JoKlasen/tsea29-autonom-taxibil/README.md

# Projekt - Taxibil
## TSEA29 - HT22 - G13

Det här är ett importerat kodrepo från liu.gitlab för arkivering av projektarbetet som vi utförde för att konstruera en autonom taxibil.
En del branches och commits kan saknas då det här var det enda jag hade sparat lokalt innan originalrepot på gitlab togs bort.

Medverkande i gruppen var Linus Thorsell, Oscar Sandell, Hannes Nöranger, Zackarias Wadströmer, Thomas Pilotti Wiger och mig, Johan Klasén.

För en bättre beskrivning av projektet se den [Tekniska dokumentationen](https://github.com/JoKlasen/tsea29-autonom-taxibil/blob/master/docs/tekdok/tekdok_1.0_grupp13.pdf), eller övriga projektdokument.
