JoKlasen/tsea29-autonom-taxibil/control-module/README.md

# Control Module
## Controls Motor and Servos via PWM signals.

Servo controller 1-2ms @ 50Hz
Motor controller 1.5ms +- ? @ 2000Hz
