JoKlasen/tsea29-autonom-taxibil/app-module/README.md

# WebApp(-module)
## Handles PID value initialization, Manual Control, Debugging and Tracking of the Taxi
