JoKlasen/tsea29-autonom-taxibil/communication-module/README.md

# Communication Module
## Handles communication between taxi-modules and the app-module.
### Is also responsible for the image-recognition from the camera.

This is the largest module, running on a raspberry pi.
