JoKlasen/tsea29-autonom-taxibil/sensor-module/README.md

# Sensor Module
## Responsible for fetching sensor data from the sensors and sending the data to the communcations module.
