JoKlasen/tsea29-autonom-taxibil/docs/generell_sv.pdf

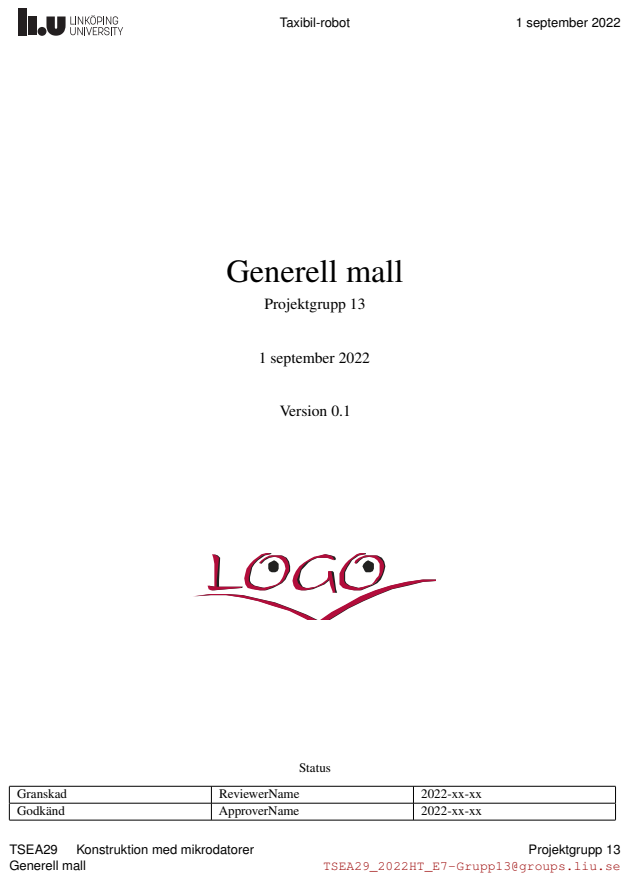
[picture p33: page 1]
Taxibil-robot; 1 september 2022; Generell mall; Projektgrupp 13; Version 0.1; Status; TSEA29; Konstruktion med mikrodatorer

Granskad | ReviewerName | 2022-xx-xx
Godkänd | ApproverName | 2022-xx-xx

TSEA29_2022HT_E7-Grupp13@groups.liu.se

Taxibil-robot | 1 september 2022

Projektidentitet

Grupp E-post: | TSEA29_2022HT_E7-Grupp13@groups.liu.se
Hemsida: | https://gitlab.liu.se/da-proj/microcomputer-project-laboratory-d/2022/g13
Beställare: | Anders Nilsson, ISY, Linköpings universitet Tfn: 013-28 26 35 E-post: anders.p.nilsson@liu.se
Kund: | Anders Nilsson, ISY, Linköpings universitet Tfn: 013-28 26 35 E-post: anders.p.nilsson@liu.se
Handledare: | Peter Johansson Tfn: 013-28 1345 E-post: peter.a.johansson@liu.se
Kursansvarig: | Anders Nilsson, ISY, Linköpings universitetn Tfn: 013-28 26 35 E-post: anders.p.nilsson@liu.se

## Projektdeltagare

Namn | Ansvar | Telefon | E-post
Linus Thorsell | Projektledare | 0765612171 | linth181@student.liu.se
Oscar Sandell | Testansvarig | 0709416866 | oscsa604@student.liu.se
Hannes Nöranger | Utvecklare | 0733118779 | hanno696@student.liu.se
Johan Klasén | Dokumentansvarig | 0730982555 | johkl473@student.liu.se
Zackarias Wadströmer | Utvecklare | 0706142029 | zacwa923@student.liu.se
Thomas Pilotti Wiger | Konstruktionsansvarig | 0761708593 | thopi836@student.liu.se
TSEA29 | Konstruktion med mikrodatorer
Generell mall

Projektgrupp 13

TSEA29_2022HT_E7-Grupp13@groups.liu.se

Taxibil-robot | 1 september 2022

### C O N T E N T S

1 Första kapitlet | 1
2 Andra kapitlet | 2
3 Tredje kapitlet | 2
4 LATEX | 4
A | Första appendix | 7
B | Andra appendix | 7
TSEA29 | Konstruktion med mikrodatorer
Generell mall

Projektgrupp 13

TSEA29_2022HT_E7-Grupp13@groups.liu.se

Taxibil-robot | 1 september 2022

### D O K U M E N T H I S TO R I K

Version | Datum | Utförda förändringar | Utförda av | Granskad
0.1 | 2015-11-01 | Första utkast | Sign1 | Name1
0.2 | 2015-11-03 | Första revision | Sign2 | Name2
TSEA29 | Konstruktion med mikrodatorer
Generell mall

Projektgrupp 13

TSEA29_2022HT_E7-Grupp13@groups.liu.se

Taxibil-robot | 1 september 2022

### 1 F Ö R S TA K A P I T L E T

Detta är en text. Detta är kursiv text. Detta är text i fetstil.

### 1.1 Alternativ till dokumentmall

Följande alternativ kan specificeras till dokumentmallen:

- Språk: english (default) eller swedish
- Sidlayout: oneside (default) eller twoside
- Fontstorlek: 10pt (default), 11pt, eller 12pt

Exempel på mallaktivering

\documentclass[10pt,oneside,english]{lips}

### 1.2 Rubrik nivå 2

Sed commodo posuere pede. Mauris ut est. Ut quis purus. Sed ac odio. Sed vehicula hendrerit sem. Duis non odio. Morbi ut dui. Sed accumsan risus eget odio. In hac habitasse platea dictumst. Pellentesque non elit. Fusce sed justo eu urna porta tincidunt. Mauris felis odio, sollicitudin sed, volutpat a, ornare ac, erat. Morbi quis dolor. Donec pellentesque, erat ac sagittis semper, nunc dui lobortis purus, quis congue purus metus ultricies tellus. Proin et quam. Class aptent taciti sociosqu ad litora torquent per conubia nostra, per inceptos hymenaeos. Praesent sapien turpis, fermentum vel, eleifend faucibus, vehicula eu, lacus.

### 1.2.1 Rubrik nivå 3

Sed commodo posuere pede. Mauris ut est. Ut quis purus. Sed ac odio. Sed vehicula hendrerit sem. Duis non odio. Morbi ut dui. Sed accumsan risus eget odio. In hac habitasse platea dictumst. Pellentesque non elit. Fusce sed justo eu urna porta tincidunt. Mauris felis odio, sollicitudin sed, volutpat a, ornare ac, erat. Morbi quis dolor. Donec pellentesque, erat ac sagittis semper, nunc dui lobortis purus, quis congue purus metus ultricies tellus. Proin et quam. Class aptent taciti sociosqu ad litora torquent per conubia nostra, per inceptos hymenaeos. Praesent sapien turpis, fermentum vel, eleifend faucibus, vehicula eu, lacus.

### 1.3 Andra rubrik nivå 2

Sed commodo posuere pede. Mauris ut est. Ut quis purus. Sed ac odio. Sed vehicula hendrerit sem. Duis non odio. Morbi ut dui. Sed accumsan risus eget odio. In hac habitasse platea dictumst. Pellentesque non elit. Fusce sed justo eu urna porta tincidunt. Mauris felis odio, sollicitudin sed, volutpat a, ornare ac, erat. Morbi quis dolor. Donec pellentesque, erat ac sagittis semper, nunc dui lobortis purus, quis congue purus metus ultricies tellus. Proin et quam. Class aptent taciti sociosqu ad litora torquent per conubia nostra, per inceptos hymenaeos. Praesent sapien turpis, fermentum vel, eleifend faucibus, vehicula eu, lacus.

TSEA29 | Konstruktion med mikrodatorer
Generell mall | 1

Projektgrupp 13

TSEA29_2022HT_E7-Grupp13@groups.liu.se

Taxibil-robot | 1 september 2022

### 1.4 Tredje rubrik nivå 2

Mer text och en Laplace-transform av funktionen f(t) F(s) = Z ∞

−∞

f(t)e

−st dt. | (1)

### 2 A N D R A K A P I T L E T

Eulers identitet med π är
e
iπ + 1 = 0 | (2)

och med τ, se [1] (se detta som ett exempel på hur on-line resurser kan citeras),

e

iτ = 1 | (3)

så här citeras ett vetenskapligt arbete[2], och så här skrivs en fotnot¹
. Information om de citerade arbetena skrivs i
filen references.bib.

### 2.1 Ytterligare en rubrik på nivå 2

Suspendisse vitae elit. Aliquam arcu neque, ornare in, ullamcorper quis, commodo eu, libero. Fusce sagittis erat at erat tristique mollis. Maecenas sapien libero, molestie et, lobortis in, sodales eget, dui. Morbi ultrices rutrum lorem. Nam elementum ullamcorper leo. Morbi dui. Aliquam sagittis. Nunc placerat. Pellentesque tristique sodales est. Maecenas imperdiet lacinia velit. Cras non urna. Morbi eros pede, suscipit ac, varius vel, egestas non, eros. Praesent malesuada, diam id pretium elementum, eros sem dictum tortor, vel consectetuer odio sem sed wisi.
Z b

a

f

0
(x) dx = f(b) − f(a) | (4)

### 3 T R E D J E K A P I T L E T

Matlab-kod kan infogas prydligt via paketet listings.sty, exempelvis så här² .

1 | function r = rank(A,tol)
% RANK | Matrix rank.
3 | % | RANK(A) provides an estimate of the number of linearly
| % | independent rows or columns of a matrix A.
5 | % | RANK(A,tol) is the number of singular values of A
| % | that are larger than tol.
7 | % | RANK(A) uses the default tol = max(size(A)) * eps(norm(A)).
| %
9 | % | Class support for input A:

1 Var konsistent med hur ni citerar, i kandidatprojekt i elektronik så används fotnötter mycket sparsamt. 2 Här, koden från Matlab-kommandot rank används som exempel.

TSEA29 | Konstruktion med mikrodatorer
Generell mall | 2

Projektgrupp 13

| | TSEA29_2022HT_E7-Grupp13@groups.liu.se

Taxibil-robot | 1 september 2022
% | float: double, single
11
% Copyright 1984-2007 The MathWorks, Inc.
13
s = svd(A);
15 if nargin==1

tol = max(size(A)) * eps(max(s)); 17 end
r = sum(s > tol);

eller Pythonkod enligt:

d e f fi n d _ma x ( L ) :
i f l e n ( L ) == 1 :
r e t u r n L [ 0 ]
v1 = L [ 0 ]
v2 = fi n d _ma x ( L [ 1 : ] ) i f v1 > v2 :
r e t u r n v1
e l s e :
r e t u r n v2

### 3.1 Inkludera figurer

Sed commodo posuere pede. Mauris ut est. Ut quis purus. Sed ac odio. Sed vehicula hendrerit sem. Duis non odio. Morbi ut dui. Sed accumsan risus eget odio. In hac habitasse platea dictumst. Pellentesque non elit. Fusce sed justo eu urna porta tincidunt. Mauris felis odio, sollicitudin sed, volutpat a, ornare ac, erat. Morbi quis dolor. Donec pellentesque, erat ac sagittis semper, nunc dui lobortis purus, quis congue purus metus ultricies tellus. Proin et quam. Class aptent taciti sociosqu ad litora torquent per conubia nostra, per inceptos hymenaeos. Praesent sapien turpis, fermentum vel, eleifend faucibus, vehicula eu, lacus.
Figur 1 vidsar en berömd bild på jorden från Apollo 17.


Figure 1: Det berömda ’The blue marble’ fotot.

TSEA29 | Konstruktion med mikrodatorer
Generell mall | 3

Projektgrupp 13

TSEA29_2022HT_E7-Grupp13@groups.liu.se

Taxibil-robot | 1 september 2022

## 4 LATEX

Den här texten är ingen introduktion till LATEX. För mer information, se online-resurser exempelvis på [3], där en bra start är dokumentet http://ctan.org/pkg/lshort. Därifrån kan även mjukvara for Linux http://www.
tug.org/texlive/, för Mac http://www.tug.org/mactex/, och för Windows http://www.miktex.
org (http://www.miktex.org) laddas ned.
För att typsätta det här dokumentet skriv

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

vid en terminal prompt för att producera filen generell_sv.pdf.

### 4.1 Att skriva krav

Sed commodo posuere pede. Mauris ut est. Ut quis purus. Sed ac odio. Sed vehicula hendrerit sem. Duis non odio. Morbi ut dui. Sed accumsan risus eget odio. In hac habitasse platea dictumst. Pellentesque non elit. Fusce sed justo eu urna porta tincidunt. Mauris felis odio, sollicitudin sed, volutpat a, ornare ac, erat. Morbi quis dolor. Donec pellentesque, erat ac sagittis semper, nunc dui lobortis purus, quis congue purus metus ultricies tellus. Proin et quam. Class aptent taciti sociosqu ad litora torquent per conubia nostra, per inceptos hymenaeos. Praesent sapien turpis, fermentum vel, eleifend faucibus, vehicula eu, lacus.
Det finns en miljö (environment) för att skriva krav, hantera numrering, och göra det möjligt att referera individuella krav. Det skall se bra ut även när tabellen spänner över flera sidor. Se källkoden för tabellen med krav nedan.
Krav | Version | Beskrivning | Prioritet
1 2 3 4 5 6 7 8 9 10 11 12 13 14 15 16 17 18 | Description Description Description Description Description Description Description Description Description Description Description Description Description Description Description Description Description Description | 2 1 1 1 1 1 1 1 1 2 1 1 1 1 1 1 1 1

forts. på nästa sida

TSEA29 | Konstruktion med mikrodatorer
Generell mall | 4

Projektgrupp 13

TSEA29_2022HT_E7-Grupp13@groups.liu.se

Taxibil-robot | 1 september 2022

forts. från föregående sida
Krav | Version | Beskrivning | Prioritet
19 20 21 22 23 24 25 26 27 28 29 30 | Description Description Description Description Description Description Description Description Description Description Description Description | 1 1 1 1 1 1 1 1 1 1 1 1

Notera att kraven 1 och 10 har prioritet 2.

TSEA29 | Konstruktion med mikrodatorer
Generell mall | 5

Projektgrupp 13

TSEA29_2022HT_E7-Grupp13@groups.liu.se

Taxibil-robot | 1 september 2022

### R E F E R E N C E S

[1] V. Hart, “PI is (still) wrong,” https://youtu.be/jG7vhMMXagQ, 2011, [Online; accessed October 30, 2015].
[2] A. Einstein, “Uber einen die erzeugung und verwandlung des lichtes betreffenden heurischen gesichtpunkt,” Ann. Phys., vol. 17, pp. 132–148, 1905.
[3] TUG, “TeX User Group web site,” http://www.tug.org, [Online; accessed October 30, 2015].
TSEA29 | Konstruktion med mikrodatorer
Generell mall | 6

Projektgrupp 13

TSEA29_2022HT_E7-Grupp13@groups.liu.se

Taxibil-robot | 1 september 2022
A | F Ö R S TA A P P E N D I X

A.1 Första underkapitel i första appendix

Fusce mauris. Vestibulum luctus nibh at lectus. Sed bibendum, nulla a faucibus semper, leo velit ultricies tellus, ac venenatis arcu wisi vel nisl. Vestibulum diam. Aliquam pellentesque, augue quis sagittis posuere, turpis lacus congue quam, in hendrerit risus eros eget felis. Maecenas eget erat in sapien mattis porttitor. Vestibulum porttitor. Nulla facilisi. Sed a turpis eu lacus commodo facilisis. Morbi fringilla, wisi in dignissim interdum, justo lectus sagittis dui, et vehicula libero dui cursus dui. Mauris tempor ligula sed lacus. Duis cursus enim ut augue. Cras ac magna. Cras nulla. Nulla egestas. Curabitur a leo. Quisque egestas wisi eget nunc. Nam feugiat lacus vel est. Curabitur consectetuer.

A.1.1 Under underkapitel i första appendix

En text.

A.2 Andra underkapitel i första appendix

Fusce mauris. Vestibulum luctus nibh at lectus. Sed bibendum, nulla a faucibus semper, leo velit ultricies tellus, ac venenatis arcu wisi vel nisl. Vestibulum diam. Aliquam pellentesque, augue quis sagittis posuere, turpis lacus congue quam, in hendrerit risus eros eget felis. Maecenas eget erat in sapien mattis porttitor. Vestibulum porttitor. Nulla facilisi. Sed a turpis eu lacus commodo facilisis. Morbi fringilla, wisi in dignissim interdum, justo lectus sagittis dui, et vehicula libero dui cursus dui. Mauris tempor ligula sed lacus. Duis cursus enim ut augue. Cras ac magna. Cras nulla. Nulla egestas. Curabitur a leo. Quisque egestas wisi eget nunc. Nam feugiat lacus vel est. Curabitur consectetuer.

A.2.1 Under underkapitel i första appendix

En text

### B A N D R A A P P E N D I X

B.1 Första underkapitel i andra appendix

Fusce mauris. Vestibulum luctus nibh at lectus. Sed bibendum, nulla a faucibus semper, leo velit ultricies tellus, ac venenatis arcu wisi vel nisl. Vestibulum diam. Aliquam pellentesque, augue quis sagittis posuere, turpis lacus congue quam, in hendrerit risus eros eget felis. Maecenas eget erat in sapien mattis porttitor. Vestibulum porttitor. Nulla facilisi. Sed a turpis eu lacus commodo facilisis. Morbi fringilla, wisi in dignissim interdum, justo lectus sagittis dui, et vehicula libero dui cursus dui. Mauris tempor ligula sed lacus. Duis cursus enim ut augue. Cras ac magna. Cras nulla. Nulla egestas. Curabitur a leo. Quisque egestas wisi eget nunc. Nam feugiat lacus vel est. Curabitur consectetuer.

TSEA29 | Konstruktion med mikrodatorer
Generell mall | 7

Projektgrupp 13

TSEA29_2022HT_E7-Grupp13@groups.liu.se

Taxibil-robot | 1 september 2022

B.1.1 Under underkapitel i andra appendix

En text

B.2 Andra underkapitel i andra appendix

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

B.2.1 Under underkapitel i andra appendix

En text

TSEA29 | Konstruktion med mikrodatorer
Generell mall | 8

Projektgrupp 13

TSEA29_2022HT_E7-Grupp13@groups.liu.se
