JoKlasen/tsea29-autonom-taxibil/docs/efterstudie/efterstudie_1.0_grupp13.pdf

Taxibil-robot | 20 december 2022

# Efterstudie

Projektgrupp 13

20 december 2022

Version 1.0

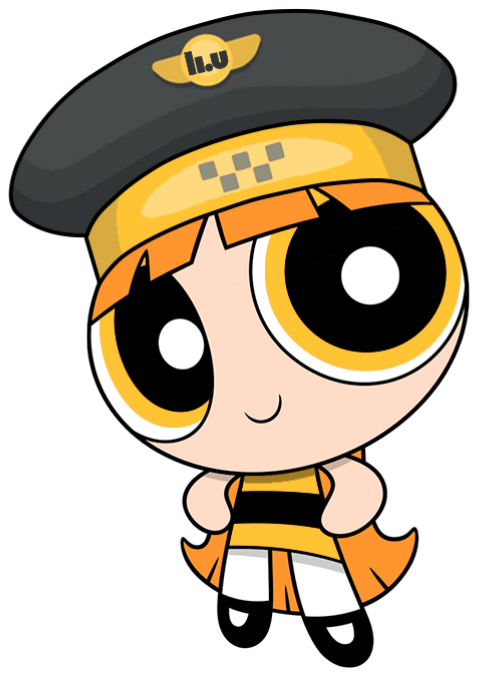
[picture p34: figure]

Status

Granskad | Johan Klasén | 2022-12-20
Godkänd | | 2022-12-20
TSEA29 | Konstruktion med mikrodatorer
Efterstudie

Projektgrupp 13

TSEA29_2022HT_E7-Grupp13@groups.liu.se

Taxibil-robot | 20 december 2022

Projektidentitet

Grupp E-post: | TSEA29_2022HT_E7-Grupp13@groups.liu.se
Hemsida: | https://gitlab.liu.se/da-proj/microcomputer-project-laboratory-d/2022/g13
Beställare: | Anders Nilsson, ISY, Linköpings universitet Tfn: 013-28 26 35 E-post: anders.p.nilsson@liu.se
Kund: | Anders Nilsson, ISY, Linköpings universitet Tfn: 013-28 26 35 E-post: anders.p.nilsson@liu.se
Handledare: | Peter Johansson Tfn: 013-28 1345 E-post: peter.a.johansson@liu.se
Kursansvarig: | Anders Nilsson, ISY, Linköpings universitetn Tfn: 013-28 26 35 E-post: anders.p.nilsson@liu.se

## Projektdeltagare

Namn | Ansvar | Telefon | E-post
Linus Thorsell | Projektledare | 0765612171 | linth181@student.liu.se
Oscar Sandell | Testansvarig | 0709416866 | oscsa604@student.liu.se
Hannes Nörager | Utvecklare | 0733118779 | hanno696@student.liu.se
Johan Klasén | Dokumentansvarig | 0730982555 | johkl473@student.liu.se
Zackarias Wadströmer | Utvecklare | 0706142029 | zacwa923@student.liu.se
Thomas Pilotti Wiger | Konstruktionsansvarig | 0761708593 | thopi836@student.liu.se
TSEA29 | Konstruktion med mikrodatorer
Efterstudie

Projektgrupp 13

TSEA29_2022HT_E7-Grupp13@groups.liu.se

Taxibil-robot | 20 december 2022

### I N N E H Å L L

1 Tidsåtgång | 1
2 Analys av arbete och problem | 1
3 Måluppfyllelse | 3
4 Sammanfattning | 3
TSEA29 | Konstruktion med mikrodatorer
Efterstudie

Projektgrupp 13

TSEA29_2022HT_E7-Grupp13@groups.liu.se

Taxibil-robot | 20 december 2022

### D O K U M E N T H I S TO R I K

Version | Datum | Utförda förändringar | Utförda av | Granskad
1.0 | 2022-12-20 | Första versionen | Gruppen | Johan
TSEA29 | Konstruktion med mikrodatorer
Efterstudie

Projektgrupp 13

TSEA29_2022HT_E7-Grupp13@groups.liu.se

Taxibil-robot | 20 december 2022

### 1 T I D S ÅT G Å N G

### 1.1 Arbetsfördelning

Vi har haft problem med att se till att det är en jämn arbetsfödelning genom hela projektet då det bara fanns en uppsättning hårdvara och majoriteten av arbetet riktades just mot denna del hårdvara. Det var för stor gruppstorlek för att endast ha en uppsättning bil. Vi har inte heller tagit höjd i planeringen för hur arbetet ska läggas upp efter att vissa nyckelsteg har uppnåtts, vilket fått personer att stå utan arbetsuppgift.

### 1.2 Tidsåtgång jämfört med planerad tid

Det var svårt att uppskatta projektets tidsåtgång men baserat på erfarenheter etc. tog vi fram en tidsplan. Denna visade sig stämma bra med hur mycket tid som behövde läggas ner för att nå projektets mål.

Fas | Planerad tid (h) | Använd tid (h)
Innan BP3 | 40 | 40
Under projektet | 855 | 863
Efter BP5 | 65 | 27,5

### 2 A N A LY S AV A R B E T E O C H P R O B L E M

Under arbetets gång har vi stött på flera problem. Allt från hårdvaruproblem, installation av bibliotek som inte fungerade som förväntat till en variation av tekniska problem/utmaningar rörande exekveringstid. Dessa har fått lösas på olika sätt, t.ex med hjälp från handledare med hårdvarubrister som gruppen inte kunde lösa själva. Bibliotek och annan variation på mjukvaruproblem löstes av gruppen till slut. Dessa tog mycket tid från projektet och gjorde problemen rörande exekveringstid svårare att felsöka, samt fördröjde efterföljande arbete. Slutligen så är det relevant att nämna att gruppen mötte en del kommunikationsproblem, mestadels via meddelanden, som gjorde det svårt för vissa medlemmar att engagera sig i relevant arbete.

### 2.1 Vad hände under de olika faserna (bra/dåligt/orsak)?

Förarbetet/designfasen flöt på bra. Det gav en bra möjlighet för alla att samla in kunskap och gruppen kunde komma överens en generell bild av hur systemet skulle se ut och vad som behövde göras. En del aktiviteter kunde eventuellt ha utökats, med det är alltid svårt att designa något helt från början utan att ha sett eller bekantat sig med hårdvaran man jobbat med eller att börja testa kodstycken. Vi gjorde vårt bästa för att försöka uppskatta aktiviteters tidsåtgång, men dessa skulle ha behövts reviderats en bit inpå projektets gång.

Under själva implementeringsfasen flöt arbetet på väldigt bra i början. Aktiviteterna stämde bra överens med vad som behövde göras och alla hade tydliga uppgifter. Längre in i projektet märkte vi att det fanns rätt mycket uppgifter som inte täcktes av någon aktivitet och andra aktiviteter inte väl speglade vad som faktiskt behövde göras. Arbetsfördelningen för aktiviteterna var inte helt optimal då vissa gruppmedlemmar snabbt klarade aktiviteterna de var tilldelade men inte hade en tydlig bild av vad för arbete dom skulle gå över till. Här skulle det ha behövts att vi någon gång gemensamt skulle gått igenom och reviderat planeringen.

TSEA29 | Konstruktion med mikrodatorer
Efterstudie | 1

Projektgrupp 13

TSEA29_2022HT_E7-Grupp13@groups.liu.se

Taxibil-robot | 20 december 2022

### 2.2 Hur vi arbetade tillsammans (ansvar, beslut, kommunikation etc.)?

Samarbetet har varit en svår del inom projektet. Detta för att kommunikationen varit bristfällig, till större eller mindre del beroende på vem du frågar i gruppen. Kvaliteten på kommunikationen på plats har varierat. Gruppen är dock överens om att kommunikationen på distans var dålig. Detta jämte schemakrockar gjorde att gruppen inte alltid kunde arbete på plats tillsammans, ledde till förvirring och dålig information kring arbetsuppgifter.

Strukturen på arbetet har gjort det svårt att avgöra vilka delar som arbetas aktivt med och vilka som är klara. Gruppen har saknat en tydlig ledare som tog ett steg tillbaka och inte fastnade i arbetet utan fokuserade på att koordinera gruppens arbetsinsats.

### 2.3 Hur använde vi projektmodellen?

Vi arbetade stegvis för att klara av de olika beslutspunkterna. Det fungerade bra. Designunderlaget var en bra utgångspunkt att utgå från vid implementationen och sparade rätt mycket tid, även om man delvis avvek från den senare inpå projektet då man stött på nya hinder som inte hade förutsett under designfasen.

### 2.4 Hur fungerade relationen med beställaren?

Arbetet mot beställaren har fungerat bra och utan friktion. Det har varit god och öppen kommunikation där sådan behövdes. Kontakten var i helhelt i anslutning till avtalade leveranstider och möten.

### 2.5 Hur fungerade relationen med handledaren?

Relationen med handledaren fungerade bra. Tillmötesgående och hjälpsam, snabb att assistera när det blev elektriska problem. Bollade idéer och implementerings-förslag med oss på en lagom nivå utan att ge för mycket handhållning.

### 2.6 Tekniska framgångar/problem

- Svårt att installera OpenCV via PIP på Raspberry Pi.
- Kameran hade en viss fördröjning i början då vi använde den vanliga (ta bild funktionen) vilket ledde till att bilderna blev sena och då fick vi en väldigt dålig respons av bilen (ca 1,25 fps i början). Detta upptäcktes genom att bilen körde av banan och sedan gjorde svängen som om den fortfarande var i banan. Detta löstes genom att vi multitrådade hämtningen av bilder genom videoström så att resterande delen av bildbehandlingen skulle ha up-to-date bilder som den kunde analysera.
- Kameran var i originalfäste inte centrerad. Standardisera mer stabila fästen.
- Dåliga fartreglage. Brände transistorer på chippet 3 gånger under projektet.
- Problem med att taxibilsscriptet inte startades från bootup. Löstes genom att göra om scriptet till en linuxdaemon process som kör i bakgrunden så fort som Raspberry-Pin startades.
- Att hantera vägkorsningar skapade flera problem med datorseendet. Dessa löstes genom att analysera hur den läste linjerna och varför den gav utslag när den gjorde och sedan hanterade problemen en i taget.
TSEA29 | Konstruktion med mikrodatorer
Efterstudie | 2

Projektgrupp 13

TSEA29_2022HT_E7-Grupp13@groups.liu.se

Taxibil-robot | 20 december 2022

En framgång var att vi snabbt och tidigt fick ihop en fungerade grundfunktionallitet på produkten. Det gick väldigt smidigt att få bilen att köra manuellt med integration mellan webbapp, kommunikationsmodul och styrmodul, även om funktionaliteten var oslipad i början såklart.

### 3 M Å L U P P F Y L L E L S E

Målen lyckades uppfyllas i tid, även om det var lite snävt mot slutet för sista beslutspunkten.

### 3.1 Vad har uppnåtts?

Vi fick fram en fungerande autonom taxibil. Bilen fungerar enligt de idéer och specifikationer gruppen satte upp i designfasen och kan utföra sitt uppdrag på ett effektivt sätt.

### 3.2 Hur fungerade leveransen?

Vi hade problem med leveransen (BP5) då vi inte hade haft särskilt mycket tid till att testa produkten innan. Därför var produkten något oslipad när vi demonstrerade den för Beställaren och behövde ytterligare några timmars justeringar för att uppnå fullgott resultat. När vi väl hade finjusterat bilen så fungerade den som den skulle när vi visade för beställaren igen några dagar senare.

### 3.3 Hur har studiesituationen påverkat projektet?

Då arbetsbelastningen i övriga kurser förändrades, möjliggjordes även mer och mindre arbete med produkten. Under sista veckorna lades därför mer tid ned, vilket tillät oss att driva projektet i mål på ett bra sätt.

### 4 S A M M A N F AT T N I N G

Projektet hade sina problem, sina framgångar och vi lyckades till slut. Vi hade problem med kommunikationen, lite tekniska problem men inget som vi inte kunde lösa :) .

### 4.1 De tre viktigaste erfarenheterna

- Lägg tid på att göra en bra design i förarbetet. En bra design gör arbetet mycket enklare och sparar massa tid i längden.
- Planera bra från början och försök följa planen så gott de går.
- Jobba på en bra kommunikation, något system för att hålla alla uppdaterade och revidera planeringen när den inte längre stämmer överens med verkligheten.
TSEA29 | Konstruktion med mikrodatorer
Efterstudie | 3

Projektgrupp 13

TSEA29_2022HT_E7-Grupp13@groups.liu.se

Taxibil-robot | 20 december 2022

### 4.2 Goda råd till de som ska utföra ett liknande projekt

Se till att kunna absorbera de personer i gruppen som inte har något att göra till de aktiviteter som fortfarande har jobb att göra. Kommunicera bättre, gärna med regelbundna gruppmöten och använd gärna en ”kanban board” där man kan se de aktiviteter som finns (kvarvarande, nuvarande och avklarade)

TSEA29 | Konstruktion med mikrodatorer
Efterstudie | 4

Projektgrupp 13

TSEA29_2022HT_E7-Grupp13@groups.liu.se
