JoKlasen/tsea29-autonom-taxibil/docs/projektplan/projektplan_0.1_grupp13.pdf

Taxibil-robot | 22 september 2022

# Projektplan

Projektgrupp 13
Powerpuffpinglorna

22 september 2022

Version 0.1


Status

Granskad | ReviewerName | 2022-09-22
Godkänd

TSEA29 Konstruktion med mikrodatorer
Projektplan

Projektgrupp 13

TSEA29_2022HT_E7-Grupp13@groups.liu.se

Taxibil-robot | 22 september 2022

Projektidentitet

Grupp E-post: | TSEA29_2022HT_E7-Grupp13@groups.liu.se
Hemsida: | https://gitlab.liu.se/da-proj/microcomputer-project-laboratory-d/2022/g13
Beställare: | Anders Nilsson, ISY, Linköpings universitet Tfn: 013-28 26 35 E-post: anders.p.nilsson@liu.se
Kund: | Anders Nilsson, ISY, Linköpings universitet Tfn: 013-28 26 35 E-post: anders.p.nilsson@liu.se
Handledare: | Peter Johansson Tfn: 013-28 1345 E-post: peter.a.johansson@liu.se
Kursansvarig: | Anders Nilsson, ISY, Linköpings universitetn Tfn: 013-28 26 35 E-post: anders.p.nilsson@liu.se

## Projektdeltagare

Namn | Ansvar | Telefon | E-post
Linus Thorsell | Projektledare | 0765612171 | linth181@student.liu.se
Oscar Sandell | Testansvarig | 0709416866 | oscsa604@student.liu.se
Hannes Nörager | Utvecklare | 0733118779 | hanno696@student.liu.se
Johan Klasén | Dokumentansvarig | 0730982555 | johkl473@student.liu.se
Zackarias Wadströmer | Utvecklare | 0706142029 | zacwa923@student.liu.se
Thomas Pilotti Wiger | Konstruktionsansvarig | 0761708593 | thopi836@student.liu.se
TSEA29 | Konstruktion med mikrodatorer
Projektplan

Projektgrupp 13

TSEA29_2022HT_E7-Grupp13@groups.liu.se

Taxibil-robot | 22 september 2022

### I N N E H Å L L

1 Beställare | 1
2 Översiktlig beskrivning av projektet | 1
3 Organisationsplan för hela projektet | 1
4 Dokumentplan | 2
5 Utvecklingsmetodik | 2
6 Utbildningplan | 3
7 Rapporteringsplan | 3
8 Mötesplan | 3
9 Resursplan | 3
10 Milstolpar och beslutspunkter | 4
11 Aktiviteter | 5
12 Testplan | 7
13 Prioriteringar | 7
14 Projektavslut | 7
TSEA29 | Konstruktion med mikrodatorer
Projektplan

Projektgrupp 13

TSEA29_2022HT_E7-Grupp13@groups.liu.se

Taxibil-robot | 22 september 2022

### D O K U M E N T H I S TO R I K

Version | Datum | Utförda förändringar | Utförda av | Granskad
0.1 | 2022-09-22 | Första utkast | Gruppen | Name1
TSEA29 | Konstruktion med mikrodatorer
Projektplan

Projektgrupp 13

TSEA29_2022HT_E7-Grupp13@groups.liu.se

Taxibil-robot | 22 september 2022

### 1 B E S TÄ L L A R E

Beställare är Anders Nilsson vid institutionen för systemteknik (ISY) på Linköpings universitet.

### 2 ÖV E R S I K T L I G B E S K R I V N I N G AV P R O J E K T E T

### 2.1 Syfte och mål

Projektets syfte är konstruktionen av en autonom taxibil. Arbetet kommer framförallt vara att utveckla systemet och den tekniska designen.

### 2.2 Leveranser

Leveranser finns listade i kravspecifikationen[1].

### 3 O R G A N I S AT I O N S P L A N F Ö R H E L A P R O J E K T E T

### 3.1 Definition av arbetsinnehåll och ansvar

Följer är en lista på de olika rollera som har tilldelats för projektet där deras uppgifter och ansvar beskrivs.

### 3.1.1 Projektledare

Projektledare ansvarar för kommunikation mellan kunden och gruppen.

### 3.1.2 Testansvarig

Testansvarig har ansvaret att förbereda och underhålla resurser för testning så att tester kan utföras vid behov och producerar läsbara resultat.

### 3.1.3 Utvecklare

Utvecklare har ansvaret för att utveckla den tekniska designen och uppdatera den efter behov.

### 3.1.4 Dokumentansvarig

Dokumentansvarig har uppgiften att se till att alla dokument levereras kompletta och i tid. Har ansvarar för hur dokumenten hanteras och att meddela andra i gruppen om det.

### 3.1.5 Konstruktionsansvarig

Konstruktiosansvarig har ansvar för materiell till konstruktion och att denna finns tillhandahållen vid konstruktionsmoment.

TSEA29 | Konstruktion med mikrodatorer
Projektplan | 1

Projektgrupp 13

TSEA29_2022HT_E7-Grupp13@groups.liu.se

Taxibil-robot | 22 september 2022

### 4 D O K U M E N T P L A N

Tabell 1: Dokumentplan
Dokument | Ansvarig/ Godkänns av | Syfte | Distribueras till | Färdig datum
Systemskiss | /Anders | Övergripande modell hur produk-ten ska designas. Ska innehålla mo-dulindelning av systemet och ett preliminärt blockschema. | Beställare, grupp | 2022-09-22
Projektplan | /Anders | Planering för projektets villkor och utförande samt övergripande fördel-ning av den tillgängliga projektti-den i form av aktiviteter. | Beställare, grupp | 2022-09-22
Tidplan | /Anders | Detaljerat schema över hur projekt-medlemmarna kommer fördela till-gängliga arbetstimmar under pro-jekttiden utgående från aktiviteter-na i projektplanen. | Beställare, grupp | 2022-09-22
Designspecifikation | /Peter | Förfining av systemskissen på tyd-lig detaljnivå över hur produkten ska konstrueras. Ska innehålla krets-och flödesscheman. | Handledare, grupp | 2022-10-13
Tekniskt dokumentation | /Anders | Komplett beskrivning av hur pro-dukten är konstruerad. | Beställare | 2022-12-14
Användarhandledning | /Anders | Tydliga instruktioner hur man an-vänder produkten. | Beställare | 2022-12-14
Tidsrapportering | /Anders | Löpande redovisning av tidsanvänd-ning till kunden. | Beställare, handledare | 2022-12-21
Efterstudie | /Anders | Sammanställning hur projektgrup-pen upplevde utförandet av av arbe-tet. | Beställare, grupp | 2022-12-21

### 5 U T V E C K L I N G S M E TO D I K

Utveckling kommer ske parvis där det är möjligt. Detta för att sprida kunskapen om kodbasen mellan fler personer och skriva bättre kod. Vid konstruktion kommer gruppen att struktureras så att det är lagom många medlemmar på plats för den givna aktiviteten. Gruppen kommer efter varje aktivitet att testa komponenten mot kraven som ställs på den.

TSEA29 | Konstruktion med mikrodatorer
Projektplan | 2

Projektgrupp 13

TSEA29_2022HT_E7-Grupp13@groups.liu.se

Taxibil-robot | 22 september 2022

### 6 U T B I L D N I N G P L A N

För att gruppens medlemmar ska kunna arbeta med projektet krävs grundläggande kunskaper inom computer vision vilket gruppen kommer behöva utbilda sig i. Gruppen kommer även att behöva studera metoder för trådlös kommunikation och utveckling av web-applikationer.

### 7 R A P P O R T E R I N G S P L A N

Tidsrapportering kommer ske kontinuerligt till beställaren efter BP3, enligt veckovis schema som beskrivs i kravspecifikationen[1].

### 8 M ÖT E S P L A N

Möten inom projektet kommer att ske mellan både medlemmar i gruppen första passet varje vecka. Inom projektet kommer det även att krävas möten med handledare och kund, dessa kommer att bokas och planeras efter hand då de behövs.

### 9 R E S U R S P L A N

### 9.1 Personer

Till projektet finns de 6 medlemmar av gruppen. Handledare finns att tillgå om oväntade problem skulle uppstå eller information krävs för att fortskrida arbetet.

### 9.2 Material

Tillgången för material till konstruktion samt begränsningar på dessa ansvarar handledare för. Utöver finns datorutrustning och en samling verktyg tillgänglig i dedikerade salar. Papper, penna och likande används till testning. 3D-printer finns tillgänglig genom handledaren.

### 9.3 Lokaler

Gruppen kommer att arbeta i lokalerna Muxen och Visionen när dessa finns tillgängliga.

### 9.4 Ekonomi

Efter att designspecifikationen har levererats till handledare förväntas varje medlem att lägga ner 160 timmars arbete.

TSEA29 | Konstruktion med mikrodatorer
Projektplan | 3

Projektgrupp 13

TSEA29_2022HT_E7-Grupp13@groups.liu.se

Taxibil-robot | 22 september 2022

### 10 M I L S TO L PA R O C H B E S L U T S P U N K T E R

### 10.1 Milstolpar

Tabell 2: Milstolpar
Nr | Beskrivning | Datum
1 | Färdigställa designspecifikationen | 2022-10-13
2 | Köra bilen genom fjärrstyrning | 2022-11-10
3 | Samla och förmedla data från sensor till kommunikations-modul | 2022-11-17
4 | Styrmodulen får sensordata och kan tolka den för att pro-ducera tolkningsbara beräkningar | 2022-11-24
5 | Enkel autonomt körning, dvs kan följa vägbanan | 2022-12-02
6 | Avancerad autonomt körning med planering | 2022-12-12

### 10.2 Beslutspunkter

Tabell 3: Beslutspunkter
Nr | Beskrivning | Datum
0 | Gruppmedlemmar och projektuppgift fastställs | 2022-09-01
1 | Kravspecifikation godkänns | 2022-09-15
2 | Systemskiss, projektplan och tidplan godkänns | 2022-09-29
3 | Designspecifikation godkänns | 2022-10-13
4 | Konstruktionsgranskning | -
5 | Verifiering av slutkrav, tillstånd för leverans | 2022-12-19
6 | Samtliga leveranser utförda, beställaren fattar beslut om projektets godkännande | 2022-12-21
TSEA29 | Konstruktion med mikrodatorer
Projektplan | 4

Projektgrupp 13

TSEA29_2022HT_E7-Grupp13@groups.liu.se

Taxibil-robot | 22 september 2022

### 11 A K T I V I T E T E R

Tabell 4: Aktiviteter
Nr | Aktivitet | Beroende av Aktivitet Nr | Beräknad tid
0.1 | Dokumentation: Skriva teknisk dokumentation | Efter aktivitet är färdig | 48
0.2 | Dokumentation: Möten och tidsrapporter | - | 140
0.3 | Dokumentation: Skriva Designspecifikation | - | 40
1.1 | General: Koppla ihop virkort för varje enskild modul | - | 10
1.2 | General: Koppla ihop Sensor, Styr och Kommunikations-modul | 1.1 | 10
2.1 | Styrmodul: Programmera rutin för att skicka pulser till fartreglage. | - 20
2.2 | Styrmodul: Programmera rutin för att skicka pulser till styrservo. | - 20
2.3 | Styrmodul: Implementera manuella styrkommandon för motor och servo | 1.1 | 40
2.4 | Styrmodul: Skapa PD-reglerings loop och tolka indata från kommunikationsmodul | - 50
3.1 | Sensor: Programmera ultraljudssensorn så att vi kan av-göra avstånd till eventuella hinder. | 1.1 | 20
3.2 | Sensor: Programmera så att vi kan ta emot data från hallsensorerna. | 1.1 | 20
4.1 | Kommunikationsmodul: | 1.1 | 15
4.2 | Kommunikationsmodul: Ta emot data och skicka vidare den | 3.1/3.2 | 30
4.3 | Kommunikationsmodul: Skicka data till extern dator över wifi | 4.2 | 20
4.4 | Kommunikationsmodul: Bildhantering av datan från ka-meran och skicka den till styrmodul | 1.1/4.2 | 200
4.5 | Kommunikationsmodul: Ta emot styrdata extern dator över wifi och skicka till styrmodulen. | 4.2 | 30
5.1 | WebApp: Designa Layout | - | 5
5.2 | WebApp: Programmera Layout | 5.1 | 17
5.3 | WebApp: Kommunicera med Kommunikations-modulen över wifi | 4.3 | 11
5.4 | WebApp: Input PID values och skicka till kommunika-tionsmodulen | 4.3 | 15
5.5 | WebApp: Ta emot livestreamad bild och visa den | 4.1/4.3 | 15
5.6 | WebApp: Manuella knappar för manuell styrning | 2.1/4.3 | 21
TSEA29 | Konstruktion med mikrodatorer
Projektplan | 5

Projektgrupp 13

TSEA29_2022HT_E7-Grupp13@groups.liu.se

Taxibil-robot | 22 september 2022

Tabell 4: Aktiviteter
Nr | Aktivitet | Beroende av Aktivitet Nr | Beräknad tid
5.7 | WebApp: Rita graf med all data som fås från kommuni-kationsmodulen. (Fel, hastighet, riktning) | 4.3 | 44
5.8 | WebApp: Rita en modell av kartan och robotens position på kartan. | 4.3 | 22
TSEA29 | Konstruktion med mikrodatorer
Projektplan | 6

Projektgrupp 13

TSEA29_2022HT_E7-Grupp13@groups.liu.se

Taxibil-robot | 22 september 2022

### 12 T E S T P L A N

När en modul har utvecklats mot att klara en milstolpe eller aktivitet kommer den att testas enligt vad modulen ska klara av för att klara av milstolpen.

### 13 P R I O R I T E R I N G A R

Prioritet kommer att hanteras enligt samma prioritet som hittas i kravspecifikationen[1]. Skalan är följande: (1) Krav,
(2) Utökat krav i mån av tid och (3) Framtida vidarutveckling

### 14 P R O J E K TAV S L U T

Projektet avslutas med en tävling mot de andra grupperna som har konstruerat autonoma taxibilar och efter det inlämningen av material till handledare.

TSEA29 | Konstruktion med mikrodatorer
Projektplan | 7

Projektgrupp 13

TSEA29_2022HT_E7-Grupp13@groups.liu.se

Taxibil-robot | 22 september 2022

### R E F E R E N S E R

[1] Projektgrupp 13, “Kravspecification,” https://gitlab.liu.se/da-proj/microcomputer-project-laboratory-d/2022/g13/docs/-/blob/master/kravspec/Kravspec_1.0_grupp13.pdf, (https://gitlab.liu.se/da-proj/microcomputer-project-laboratory-d/2022/g13/docs/-/blob/master/kravspec/Kravspec_1.0_grupp13.pdf) internt projektdokument i samråd med beställaren.
TSEA29 | Konstruktion med mikrodatorer
Projektplan | 8

Projektgrupp 13

TSEA29_2022HT_E7-Grupp13@groups.liu.se
