JoKlasen/tsea29-autonom-taxibil/docs/kravspec/Figures/delsys1.pdf

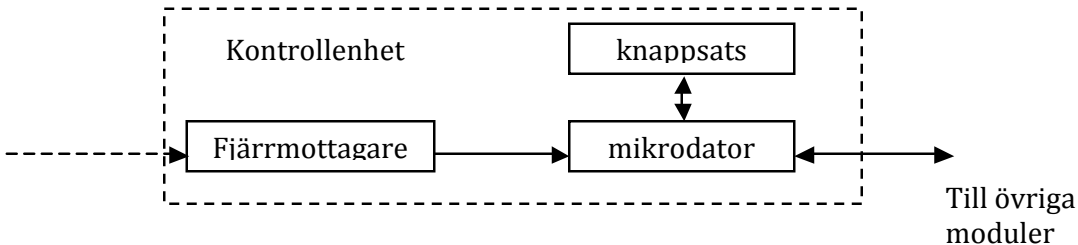
[picture p41: figure]
Fjärrmottagare; knappsats; mikrodator; Kontrollenhet; Till övriga moduler
