JoKlasen/tsea29-autonom-taxibil/docs/kravspec/Figures/delsys2.pdf

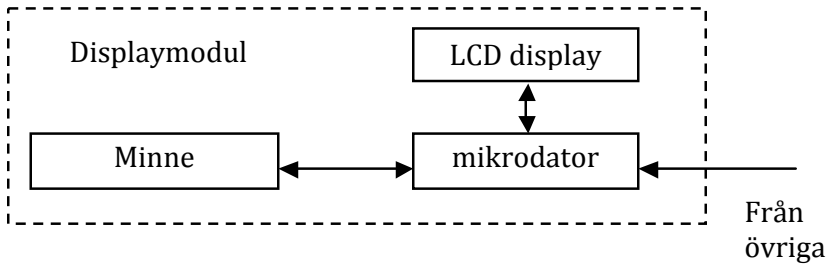
[picture p42: figure]
Minne; LCD display; mikrodator; Displaymodul; Från övriga
