JoKlasen/tsea29-autonom-taxibil/docs/kravspec/Figures/outline.pdf

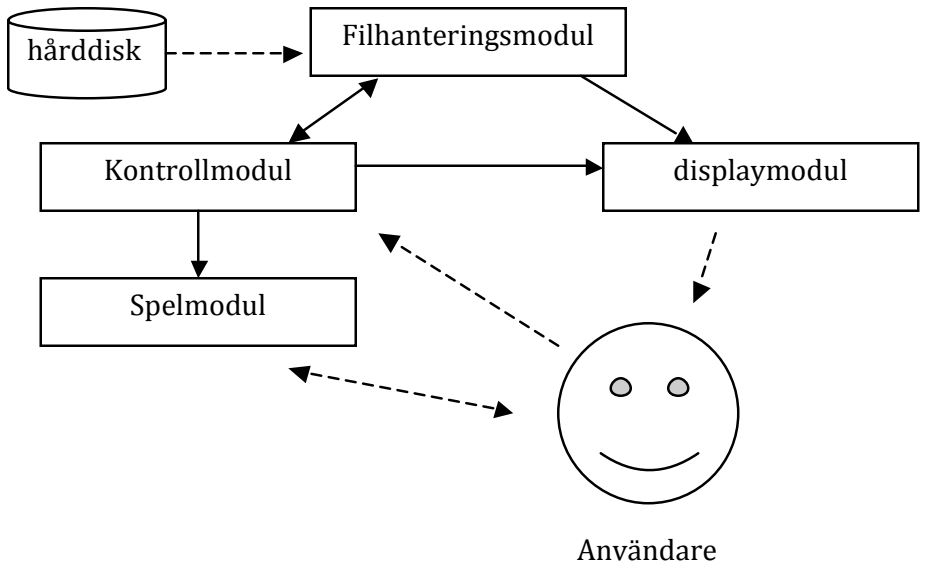
[picture p43: figure]
Filhanteringsmodul; Kontrollmodul; displaymodul; Spelmodul; Användare; hårddisk
