JoKlasen/tsea29-autonom-taxibil/docs/kravspec/Figures/sys.pdf

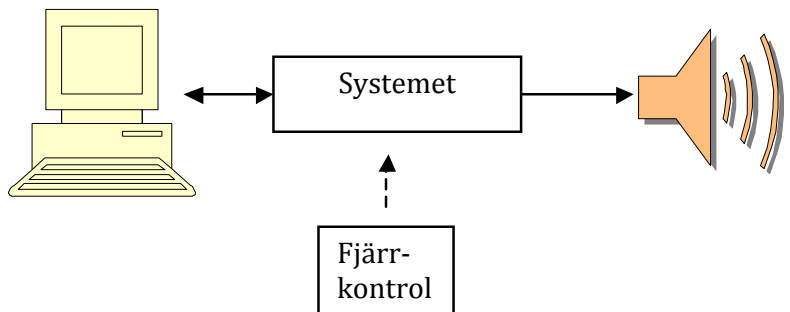
[picture p44: figure]
Systemet; Fjärr- kontrol
