JoKlasen/tsea29-autonom-taxibil/communication-module/Chesstest_160x128/CI_22.11.24.11.21.51.jpg

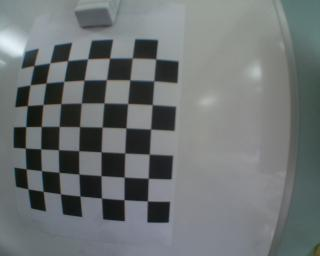
communication-module/Chesstest_160x128/CI_22.11.24.11.21.51.jpg
