JoKlasen/tsea29-autonom-taxibil/communication-module/Lanetest_640x480/vlcsnap-2022-11-21-09h46m29s769.png

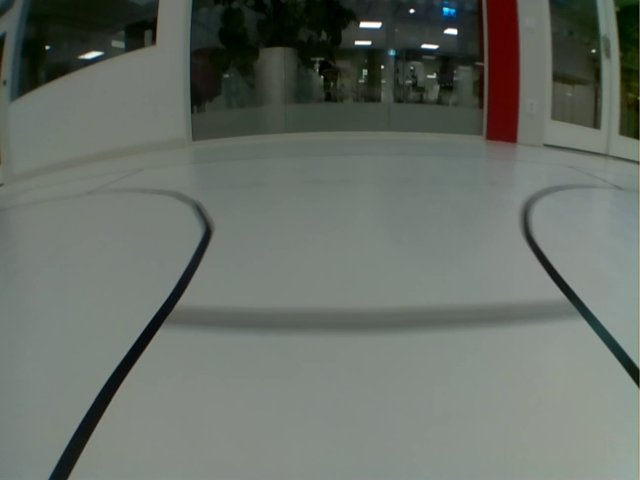
communication-module/Lanetest_640x480/vlcsnap-2022-11-21-09h46m29s769.png
