JoKlasen/tsea29-autonom-taxibil/communication-module/Lanetest_640x480/vlcsnap-2022-11-21-09h46m58s521.png

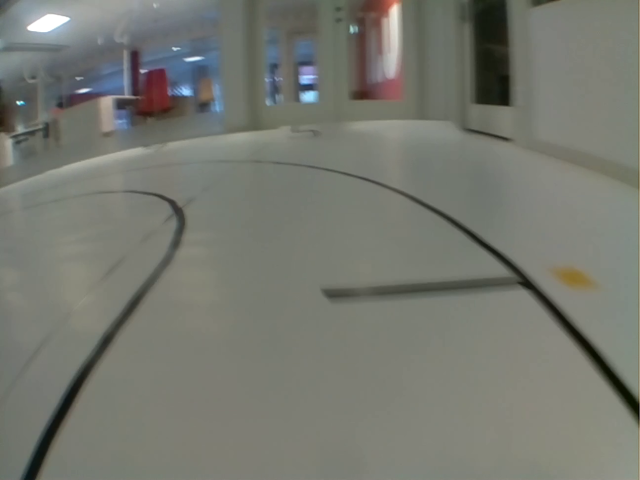
communication-module/Lanetest_640x480/vlcsnap-2022-11-21-09h46m58s521.png
