JoKlasen/tsea29-autonom-taxibil/communication-module/Lanetest_640x480/vlcsnap-2022-11-21-09h47m05s487.png

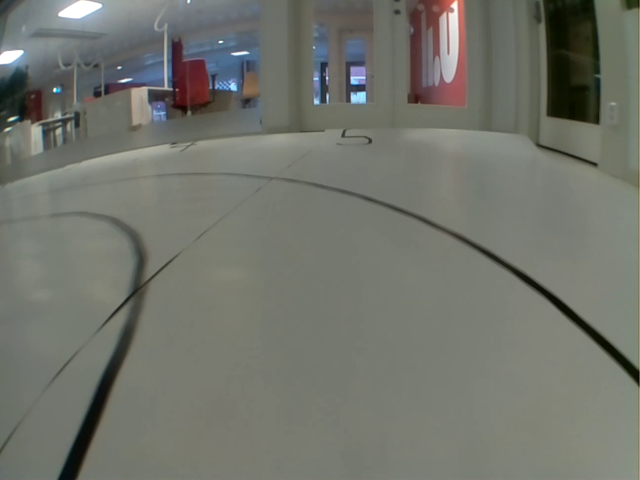
communication-module/Lanetest_640x480/vlcsnap-2022-11-21-09h47m05s487.png
