JoKlasen/tsea29-autonom-taxibil/communication-module/Lanetest_640x480/vlcsnap-2022-11-21-09h47m31s351.png

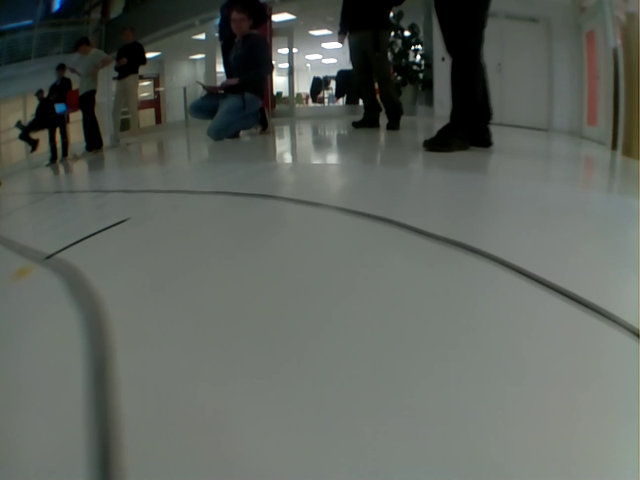
communication-module/Lanetest_640x480/vlcsnap-2022-11-21-09h47m31s351.png
