JoKlasen/tsea29-autonom-taxibil/communication-module/Lanetest_640x480/vlcsnap-2022-11-21-09h47m49s729.png

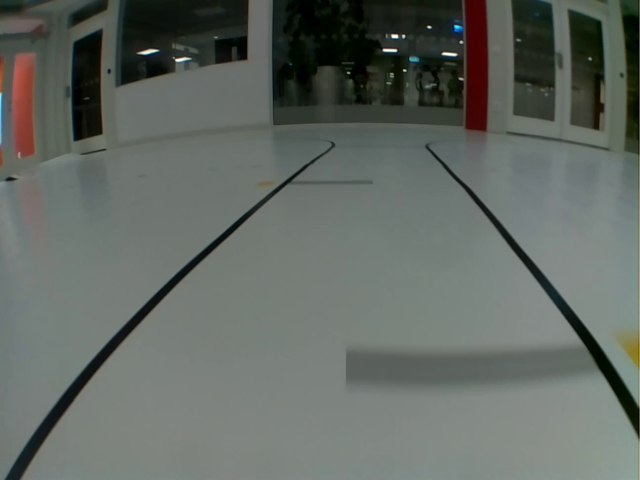
communication-module/Lanetest_640x480/vlcsnap-2022-11-21-09h47m49s729.png
