JoKlasen/tsea29-autonom-taxibil/communication-module/Lanetest_640x480/vlcsnap-2022-11-21-09h48m05s785.png

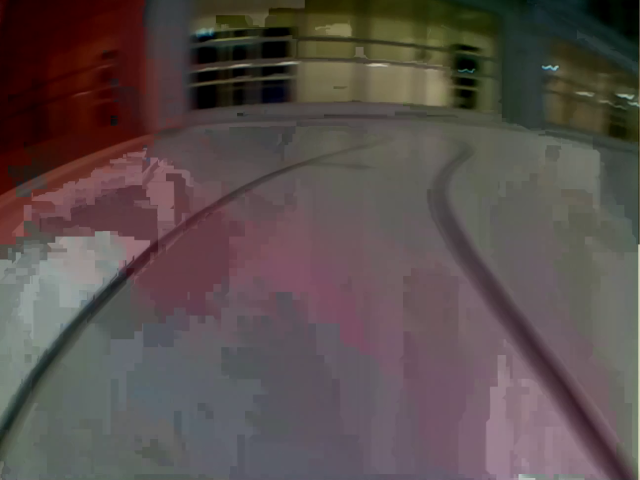
communication-module/Lanetest_640x480/vlcsnap-2022-11-21-09h48m05s785.png
