JoKlasen/tsea29-autonom-taxibil/communication-module/Lanetest_640x480/vlcsnap-2022-11-21-09h48m12s895.png

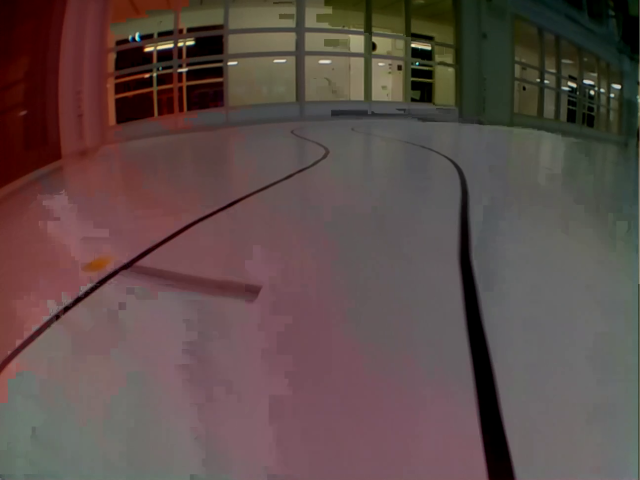
communication-module/Lanetest_640x480/vlcsnap-2022-11-21-09h48m12s895.png
