JoKlasen/tsea29-autonom-taxibil/datasheets/SRF04_Technical_Documentation_files/srf04diagram.gif

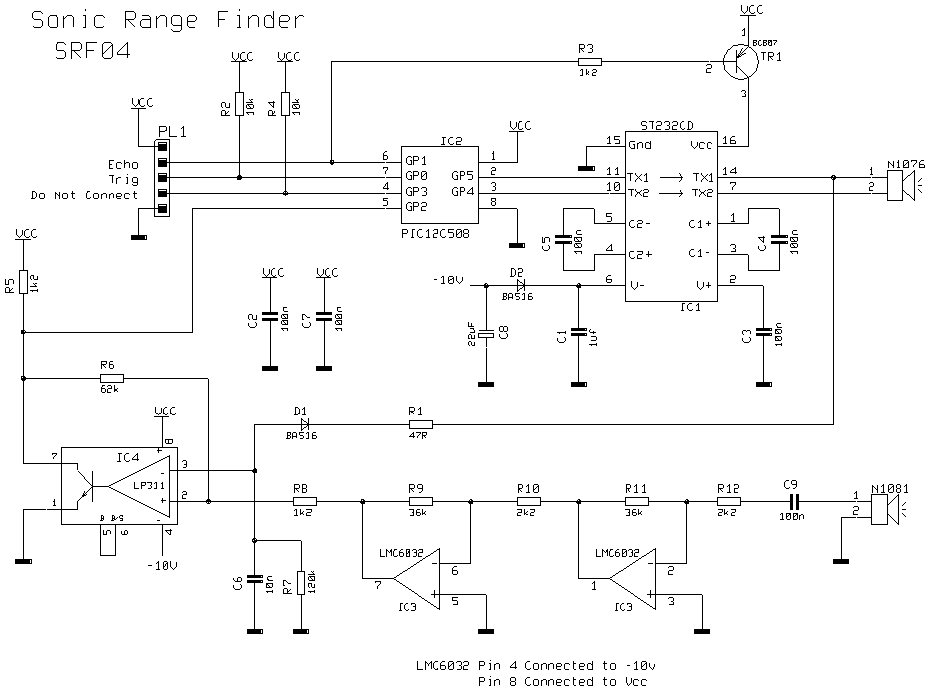
datasheets/SRF04_Technical_Documentation_files/srf04diagram.gif
