JoKlasen/tsea29-autonom-taxibil/docs/Figures/Sensormodul.drawio.png

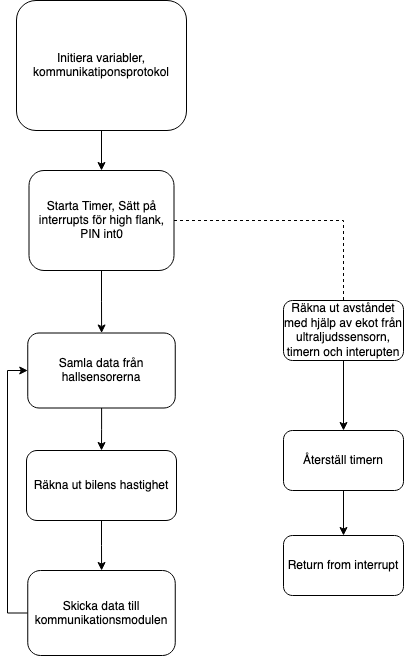
docs/Figures/Sensormodul.drawio.png
