JoKlasen/tsea29-autonom-taxibil/communication-module/test.png

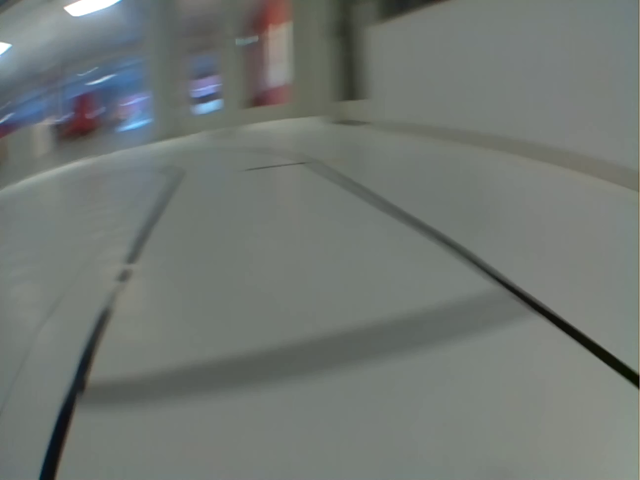
communication-module/test.png
