JoKlasen/tsea29-autonom-taxibil/docs/Figures/logo.pdf

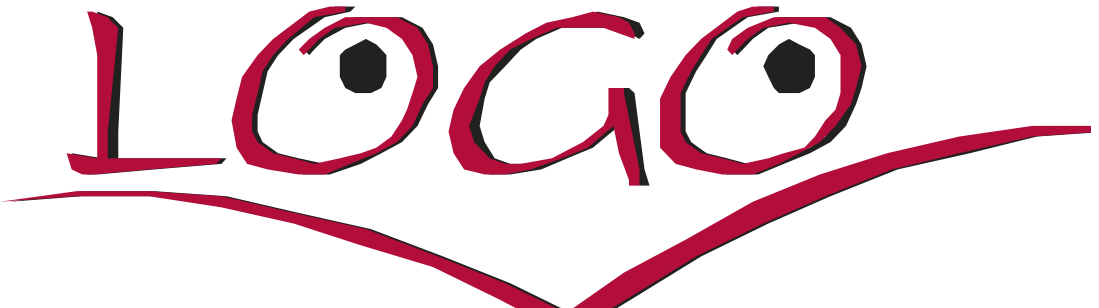
[picture p69: page 1]
