JoKlasen/tsea29-autonom-taxibil/sensor-module/SensorModule/SensorModule/main.cpp

/*
 * SensorModule.cpp
 *
 * Created: 2022-11-02 08:26:16
 * Author : johkl473
 */ 

#include <avr/io.h>
#include <avr/interrupt.h>
#include <stdlib.h>
#include <string.h>
#include <stdio.h>


//Port Definitions			Ben:
#define UART_RX		 PD0 // 14
#define UART_TX		 PD1 // 15

#define LED1		 PA0 // 40
#define LED2		 PA1 // 39

#define ECHO_OUTPUT	 PB2 // 3
#define ECHO_TRIGGER PB3 // 4
#define HALL_RIGHT	 PD2 // 16
#define HALL_LEFT	 PD3 // 17


// Constants
#define F_CPU 16000000UL
#define USART_BAUDRATE 57600
#define BAUD_PRESCALE (((F_CPU / (USART_BAUDRATE * 16UL))) - 1)	

#define SEND_RATE 250 // How long the main loop should wait before sending new data in ms

#define SPEED_PRECISION 1000 // 3 decimalers precision
#define SPEED_CONSTANT 0.026 * 3.6 * 1000 * SPEED_PRECISION // konvertering till km/h med 0 decimalers shiftning �t v�nster, f�r 1 tick

#define RECEIVE_BUFFER_SIZE 100

// Timing variables
volatile unsigned short interval_counter = 0;
volatile unsigned long long milliseconds = 0;
volatile unsigned long long echo_start = 0;
volatile unsigned long long	echo_end = 0;
volatile unsigned long long hall_left_latest = 0;
volatile unsigned long long hall_left_previous = 0;
volatile unsigned long long hall_left_old = 0;
volatile unsigned long long hall_right_latest = 0;
volatile unsigned long long new_time = 0;
volatile unsigned long long timeout_counter = 0;
volatile int speed = 0;
// ISR flags
volatile bool echo_updated = false;
volatile bool hall_left_updated = false;
volatile bool hall_right_updated = false;  

//Skicka data med j�mnt intervall
volatile bool sendbool = false;

//F�r att ta emot data
volatile bool received = false;
char receive_buffer[RECEIVE_BUFFER_SIZE];
char working_buffer[RECEIVE_BUFFER_SIZE];
volatile int receive_buffer_index = 0;

volatile int hall_left_counter = 0;

// Function predeclarations
void portinit();
void UART_init();
void timer0_init();
void timer1_init();
void ext_intr_init();



// ======================
// Help functions
// ======================

void send_data(char* data)
{
	int counter=0;
	while(1)
	{
		while(!( UCSR0A & (1<<UDRE0)))
		;
		
		UDR0 = data[counter];
		if (data[counter] == '\0')
		{
			break;
		}
		counter++;
	}
}


unsigned long long millis()
{
	cli();
	unsigned long long tempmillis = milliseconds;
	sei();
	return tempmillis;
}


void start_echo_pulse()
{
	cli();
	// Start Timer0
	TCNT0 = 0;
	TCCR0B |= (1<<CS00);
	// Start tigger pulse
	PORTB |= (1<<ECHO_TRIGGER);
	sei();
}

void clear_buffer(char* buffer,int size = RECEIVE_BUFFER_SIZE)
{
	for(int i = 0;i < size ;i++)
	{
		buffer[i] = '\0';
	}

}

bool parse_handshake()
{
	if(!strcmp(&working_buffer[0], "ACK"))
	{
		return true;
	}
	return false;
}

void handshake()
{
	while(1)
	{
		if(millis()-new_time > 100)
		{
			new_time = millis();
			//Denna ska va h�r ---- start
			send_data("sensor_module\n");
			//Denna ska va h�r ---- slut
			if(received)
			{
				cli();
				received = false;
				if(parse_handshake()) //ACK
				{
					sei();
					return;
				}
				sei();	
			}
		}
	}
}




// ======================
// Main program
// ======================

void setup()
{
	portinit();
	UART_init();
	timer0_init();
	timer1_init();
	ext_intr_init();
	sei();
}

int main(void)
{
	setup();
	char* Data= "Init Completed! :)\n";
	send_data(Data);
	volatile bool localsend = false;	
	volatile bool localultrasound = false;

	char initial[50];
	char * speed_msg = &initial[0]; 
	
	volatile int local_hall_counter = 0;
	volatile unsigned long long local_hall_left_latest = 0;
	
	volatile unsigned pulse_length = 0;
	volatile unsigned heltal = 0;
	volatile unsigned decimal = 0;
	
	//char receive_buffer[RECEIVE_BUFFER_SIZE]; 
	clear_buffer(&receive_buffer[0]);
	clear_buffer(&working_buffer[0]);
	memset(receive_buffer,0,sizeof receive_buffer);
	memset(working_buffer,0,sizeof working_buffer);


	handshake();
	PORTA |= (1 << LED2);
	while(1)
	{
		cli();
		localultrasound = echo_updated;
		sei();
		if (localultrasound)
		{
			pulse_length = echo_end - echo_start;
			echo_updated = false;
		}
		
		
		cli();
		localsend = sendbool;
		sei();
		if(localsend)
		{
			sprintf(speed_msg,"tm:s=%u:d=%u:\n",speed,pulse_length);
			send_data(speed_msg);
			cli();
			sendbool = false;
			sei();
			
		}
		
	}
	return 0;
}


// ======================
// Interrupt Service Routines 
// ======================

ISR(TIMER0_COMPA_vect)
{
	// Stop Timer0
	TCCR0B &= ~(1<<CS00);
	// End trigger pulse
	PORTB &= ~(1<<ECHO_TRIGGER);
	echo_start = millis();
}

ISR(TIMER1_COMPA_vect)
{
	milliseconds++;
	interval_counter++;
	timeout_counter++;
	if(timeout_counter == 1000)
	{
		speed = 0;
	}
	if(interval_counter == 100)
	{
		sendbool = true;
		interval_counter = 0;
		start_echo_pulse();
	}

}

//HALL_RIGHT
ISR(INT0_vect)
{
	char * data = "Right Hallsensor!\n";
	send_data(data);
}

//HALL_LEFT
ISR(INT1_vect)
{
	//hall_left_counter++;
	hall_left_previous = hall_left_latest;
	hall_left_latest = millis();
	speed = (((float)1)/ ((float)(hall_left_latest - hall_left_previous))) * 100000.0;
	timeout_counter = 0;

}

//ECHO_OUTPUT
ISR(INT2_vect)
{
	echo_end = millis();
	echo_updated = true;
}



// ======================
// Initiation functions
// ======================

void portinit()
{
	PORTA = (1 << LED1) | (0 << LED2);
	DDRA = (1 << LED1) | (1 << LED2);
	
	PORTD = (0 << HALL_LEFT) | (0 << HALL_RIGHT) | (1 << UART_TX) | (1 << UART_RX); // (0 << PD5) for testing
	// output == 1 input == 0
	DDRD = (0 << HALL_LEFT) | (0 << HALL_RIGHT) | (1 << UART_TX) | (0 << UART_RX); // (1 << DDD5)|(1 << DDD4) for testing
		
	PORTD = (0 << ECHO_TRIGGER);
	DDRB = (1 << ECHO_TRIGGER)|(0 << ECHO_OUTPUT);
}


void UART_init()
{
	/* Set baud rate */
	UBRR0H = (BAUD_PRESCALE>>8);
	UBRR0L = BAUD_PRESCALE;
		
	/* Enable receiver and transmitter */
	UCSR0B = (1<<RXEN0)|(1<<TXEN0);
	/* Set frame format: 8data, 2stop bit */
	UCSR0C = (1<<USBS0)|(3<<UCSZ00)|(0<<UPM00)|(0<<UPM01);
	
	UCSR0B |= (1 << RXCIE0);
}

ISR (USART0_RX_vect)
{
	
	unsigned char from_receive_buffer = UDR0;
	receive_buffer[(receive_buffer_index)++] = from_receive_buffer;


	if((from_receive_buffer == '\0') || ((receive_buffer_index) == RECEIVE_BUFFER_SIZE-2) || (from_receive_buffer == '\n') || (from_receive_buffer == ';'))
	{
		receive_buffer[receive_buffer_index] = from_receive_buffer;
		/*send_data("From UART: ");
		send_data(receive_buffer);
		send_data("\n");*/
		strlcpy(working_buffer,receive_buffer,receive_buffer_index);
		/*send_data("I working buffer i ISR: ");
		send_data(working_buffer);
		send_data("\n");*/
		memset(receive_buffer,0,receive_buffer_index);
		receive_buffer_index =0;
		received = true;


	}
}
void timer0_init() // PWM variant
{
	// Set Output Compare Register to 160 which is 10 us at 16MHz
	OCR0A = 160; // == 10 us
	
	//CTC-mode with no prescaler, COM0 in normal operation OC0A/B disabled
	TCCR0A = (0<<COM0A1) | (0<<COM0A1) | (1<<WGM01) | (1<<WGM00);
	TCCR0B = (0<<WGM02)	 | (0<<CS00);
	
	// Enable Output Compare A Match Interrupt Enable
	TIMSK0 = (1<<OCIE0A);
}


void timer1_init()
{
	// Set Output Compare Register to 16000 which is 1 ms at 16MHz
	OCR1A = 16000; // == 0x3E80
	
	//CTC = Clear Timer on Compare-mode with no prescaler, COM1 in normal operation OC1A/B disabled
	TCCR1A = (0<<WGM11) | (0<<WGM10); 
	TCCR1B = (1<<WGM12) | (1<<CS10);
	// Enable Output Compare A Match Interrupt Enable
	TIMSK1 = (1<<OCIE1A);
}


void ext_intr_init()
{
	//Set control mode and enable External Interrupt routines
	//Modes: 2 == falling edge // 3 == raising edge // 1 == any change
	
	EICRA = (2 << ISC20) | (3 << ISC10) | (3 << ISC00);
	EIMSK = (1 << INT2) | (1 << INT1) | (0 << INT0);
}
