JoKlasen/tsea29-autonom-taxibil/(commit log)

2022-11-02 Initial atmel studio sensor project
2022-11-02 Tabel for jtag connections wiring
    [Jtag-connections.xlsx]
2022-11-02 Got the button to work! starting USART
2022-11-03 Sensormodule: Finished timer interrupt with millis()-func, senors ISR partially implemented and main loop odometer speed almost done.
2022-11-05 Computer vision stuff. Uptil edge detection
    [Calibration-Params.txt]
2022-11-05 Upload New File
    [speed_unitscale.xlsx]
2022-11-05 Camera finetuned
2022-11-07 ControlModule: Edited readme, added timers (WIP)
2022-11-07 Implemented PWM outputs for speed and steering on the controlmodule. Next step is to read from UART, parse commandos and add speed part of main loop.
    [servo_range.xlsx]
2022-11-08 Finished speed telemetry sending, converted to km/h
    [speed_unitscale.xlsx]
2022-11-08 början på ultraljud
    [speed_unitscale.xlsx]
2022-11-09 Finished ultrasound detection which is printed as detection=<int> in ms. Cleaned up code and reordered functions.
2022-11-09 Fixat uart, ligger i sensormodulen än så länge
    [main.cpp]
2022-11-10 CM: Improved data receiver, for/back not working
    [main.cpp]
2022-11-11 Pathfinding and timer for Control_Module
2022-11-14 fix atmel studio goof
    [main.cpp]
2022-11-14 added definitions for pid loop
2022-11-14 added basic proportional pid loop
2022-11-14 pid loop done
2022-11-15 First UART with interrupt
2022-11-15 UART works something wrong with forward
    [main.cpp]
2022-11-15 interrupt uart, handhake with ccontrol unit implemented
2022-11-15 Working UART-INTERRUPT med handshake
2022-11-16 Fixed parser, know just minimize the repetition
    [main.cpp]
2022-11-17 temporary fix to allow refreshing of webapp
    will need to change this behavior once the server has to relay commands
    from the sensor module to the control module.
    [server.py]
2022-11-18 Fixade en otunead pidloop med linus
    [definitions.h, global_variables.h, implementations.cpp, main.cpp, parser.cpp, pid.cpp]
2022-11-18 Added all necessary functionality for fundamental computer vision <=
    [Calibration-Params.txt]
2022-11-18 Tror jag fixade felen
    [Pathfinding.py]
2022-11-18 Parameters calibrated a bit, enough for thorough testing
    [Calibration-Params.txt]
2022-11-23 Tuned a little pid
2022-11-23 Fixed somethings for automode
    [definitions.h, main.cpp, parser.cpp]
2022-11-23 Error be better after the storm
    [detection.py, main.py]
2022-11-25 Changed DIR and BRAKE pinout from port A to port B for easier wiring and clearer initialisation
2022-11-28 LED array initiation to display handshake
2022-11-28 Fixed detection brake functions and modified odometer calculation to show speed as zero when car is not moving.
    [definitions.h, implementations.cpp, main.cpp, parser.cpp]
2022-11-29 fixed corrupt repository smh
    [Calibration-Params_Test.txt]
2022-12-05 Shortened the commands whih should make it faster
    [parser.cpp]
2022-12-06 Fixed result folder formatting
    [main.py]
2022-12-06 Added a Handshake function on sensormodule
2022-12-06 Made steering error deadzone smaller
    [detection.py]
2022-12-07 Speed PID-regulation outline, not complete
2022-12-07 changes stashed to switch to master testing
2022-12-07 Added aux. functions in camera + tests
2022-12-08 OpenCV-stream: Now supports tests and preview, TODO: Implement in calibrate
2022-12-08 Implemented in calibrate (indentation?), TODO: time based preview
2022-12-08 Camera tested. TODO: Change all cam.read, autowhiteblance etc
2022-12-08 Start of calibration
    [config.txt]
2022-12-08 Fixed and cleaned up sensormodule
    [main.cpp]
2022-12-08 Config is fixed, ready for merge
    [detection.py, driving_logic.py, main.py]
2022-12-09 Camera fixes. TODO: live update test, time based photos
    [calibrate.py, opencv_stream.py]
2022-12-09 Fixed small issues within main.py and detection.py
    [config.txt]
2022-12-09 Fixed stash. Needed to be confirmed
    [detection.py]
2022-12-10 Camera v3: Test cases done, interrupt-preview on time implemented
2022-12-10 fixing stuff
    [config.txt]
2022-12-13 Working on speed pid
2022-12-13 fixed last logic for driving, and pathfinding
    [Pathfinding.py, detection.py, driving_logic.py, main.py]
2022-12-13 Tried to implement conversion in threads but not tested yet
2022-12-14 pid works
2022-12-14 Speed pid done
2022-12-14 Required fixes to threading and detection
    [detection.py, main.py]
2022-12-14 works, but is slightly righty
    [config.txt]
2022-12-15 Last preperations for demo, works
    [config.txt]
2024-03-26 Added project documentation
    [Tidplan_V46.xlsx, Tidplan_V47.xlsx, Tidplan_v43.xlsx, Tidplan_v44.xlsx, Tidplan_v45.xlsx, Tidplan_v48.xlsx, Tidplan_v49.xlsx, Tidplan_v51.xlsx]
